stewdk/pwct/wiki/invacare.png

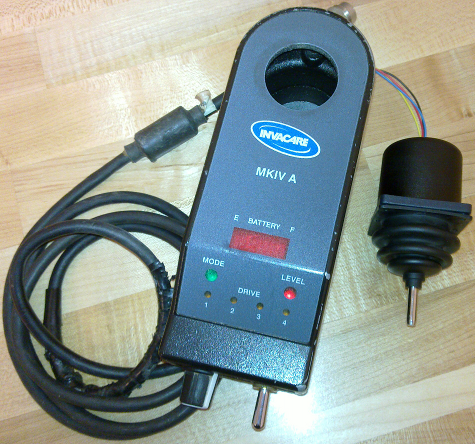
wiki/invacare.png
