stewdk/pwct/wiki/invacare_direction.png

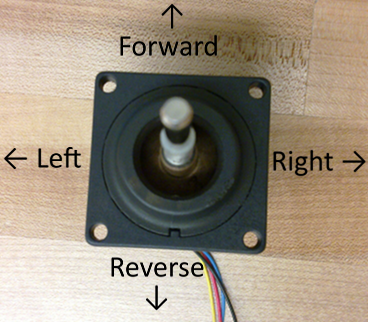
wiki/invacare_direction.png
