stewdk/pwct/hardware/wheelchair/gerber/gerber file info.txt

.GTL top copper
.GBL bottom copper
.GTO top silkscreen
.GBO bottom silkscreen
.GTS top soldermask
.GBS bottom soldermask
.TXT excellon drill file
.GML rs274x mill layer (empty)
