stewdk/pwct/wiki/remoteplus.png

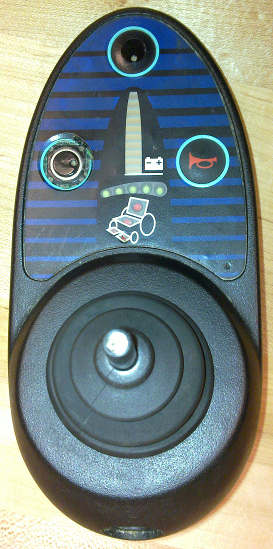
wiki/remoteplus.png
