stewdk/pwct/hardware/Wheelchair Receiver BOM.xlsx

 |  |  |  |  |  |  |  | Total: | $239.43
ID # | Manufacturer | MFG Part # | Description | Supplier | Supplier Part # | Schematic Ref. | Price | Qty | Sub Total | NOTES
Resistors |  |  |  |  |  |  |  |  | $0.00
1 | Stackpole Electronics | RMCF0805JT10K0 | 10kΩ 0805 | Digi-Key | RMCF0805JT10K0CT-ND | R4, R7, R8, R10, R11, R12, R13, R14, R15, R17, R18, R19, R20, R22, R23, R24, R27, R28, R31, R32, R33, R34, R36, R37, R41, R42, R48, R49, R51, R52, R53, R54, R55, R57, R65, R66, R67, R68, R72, R75, R77, R78, R79, R80, R81, R82, R83, R84 | $0.03 | 48 | $1.44
2 | Stackpole Electronics | RMCF0402FT1M00 | 1M 0402 | Digi-Key | RMCF0402FT1M00CT-ND | R1 | $0.04 | 1 | $0.04
3 | Panasonic | ERJ-2RKF2202X | 22k 0402 | Digi-Key | P22.0KLCT-ND | R2 | $0.10 | 1 | $0.10
4 | Panasonic | ERJ-6ENF40R2V | 40 0805 | Digi-Key | P40.2CCT-ND | R3, R69, R70 | $0.10 | 3 | $0.30
5 | Stackpole Electronics | RMCF0805FT147R | 145 0805 | Digi-Key | RMCF0805FT147RCT-ND | R16 | $0.04 | 1 | $0.04
6 | Stackpole Electronics | RMCF0805FT100K | 100k 0805 | Digi-Key | RMCF0805FT100KCT-ND | R21, R43, R44, R45, R46, R47, R64 | $0.04 | 7 | $0.28 | have some
7 | Panasonic | ERJ-6ENF1100V | 110 0805 | Digi-Key | P110CCT-ND | R35 | $0.10 | 1 | $0.10
8 | Stackpole Electronics | RMCF0805FT12K4 | 12.5k 0805 | Digi-Key | RMCF0805FT12K4CT-ND | R38 | $0.04 | 1 | $0.04
9 | Stackpole Electronics | RMCF0805FT1K00 | 1k 0805 | Digi-Key | RMCF0805FT1K00CT-ND | R39, R71, R73 | $0.04 | 3 | $0.12 | already have
10 | Panasonic | ERJ-6ENF4020V | 400 0805 | Digi-Key | P402CCT-ND | R40 | $0.10 | 1 | $0.10
11 | Stackpole Electronics | RMCF0805JT15R0 | 15 0805 | Digi-Key | RMCF0805JT15R0CT-ND | R5, R6, R25, R26, R29, R30, R50, R56 | $0.03 | 8 | $0.24
12 | Stackpole Electronics | RMCF0805FT220R | 220 0805 | Digi-Key | RMCF0805FT220RCT-ND | R58, R59, R60, R61, R62, R63 | $0.04 | 6 | $0.24
13 | Stackpole Electronics | RMCF0805ZT0R00 | 0 0805 | Digi-Key | RMCF0805ZT0R00CT-ND | R9, R74 | $0.03 | 2 | $0.06 | already have
14 | Bourns Inc | 3362P-1-203LF | 20k Potentiometer | Digi-Key | 3362P-203LF-ND | R76 | $1.05 | 1 | $1.05
 |  |  |  |  |  |  |  |  | $0.00
Capacitors |  |  |  |  |  |  |  |  | $0.00
1 | Kemet | T491C107K016ZT | 100uF 2312 | Digi-Key | 399-5214-1-ND | C11, C12 | $1.34 | 2 | $2.68 | Voltage regulator input/output cap
2 | Kemet | C0805C103K5RACTU | 0.01uF 0805 | Digi-Key | 399-1158-1-ND | C10, C16, C21, C26, C31 | $0.05 | 5 | $0.25 | Voltage Regulator boost cap
3 | Taiyo Yuden | TMK105B7103KV-F | 10nF 0402 | Digi-Key | 587-1223-1-ND | C8 | $0.05 | 1 | $0.05
4 | Taiyo Yuden | UMK105B7102KV-F | 1nF 0402 | Digi-Key | 587-1220-1-ND | C9 | $0.05 | 1 | $0.05
5 | Taiyo Yuden | UMK105B7222KV-F | 2.2nF 0402 | Digi-Key | 587-1221-1-ND | C4 | $0.05 | 1 | $0.05
6 | Taiyo Yuden | UMK105CG220JV-F | 22pF 0402 | Digi-Key | 587-1203-1-ND | C1,C2 | $0.06 | 2 | $0.12
7 | Johanson Technology Inc | 500R07S1R0BV4T | 1pF 0402 | Digi-Key | 712-1266-1-ND | C6 | $0.19 | 1 | $0.19
8 | Johanson Technology Inc | 500R07S4R7BV4T | 4.7pF 0402 | Digi-Key | 712-1166-1-ND | C5 | $0.26 | 1 | $0.26
9 | AVX Corp | 04025U1R5BAT2A | 1.5pF 0402 | Digi-Key | 478-5992-1-ND | C7 | $0.16 | 1 | $0.16
10 | TDK Corporation | C1005X7R1E333K | 33nF 0402 | Digi-Key | 445-4939-1-ND | C3 | $0.04 | 1 | $0.04 | Min qty 10
11 | AVX Corp | 08055C104JAT2A | 0.1uF 0805 | Digi-Key | 478-3352-1-ND | C17, C18, C19, C22, C23, C24, C27, C28, C29, C32, C33, C34, C35, C36, C37, C38, C41, C42, C45, C48, C49, C50 | $0.05 | 22 | $1.10 | already have
12 | AVX Corp | 0805PC102KAT1A | 1nF 0805 | Digi-Key | 478-5541-1-ND | C15, C20, C25, C30, C51, C52 | $0.30 | 6 | $1.80 | already have
13 | Murata Electronics | GRM21BR61E106KA73L | 10uF 0805 | Digi-Key | 490-5523-1-ND | C13, C39, C43, C46 | $0.26 | 4 | $1.04
14 | Taiyo Yuden | UMK212BJ105KG-T | 1uF 0805 | Digi-Key | 587-2229-1-ND | C14, C40, C44, C47 | $0.39 | 4 | $1.56 | already have
 |  |  |  |  |  |  |  |  | $0.00
IC |  |  |  |  |  |  |  |  | $0.00
1 | National Semiconductor | LM2674M-3.3/NOPB | 3.3 voltage regulator | Digi-Key | LM2674M-3.3-ND | IC3 | $3.47 | 1 | $3.47
2 | Nordic Semiconductor | nRF24L01P-T | Nordic 2.4GHz Wireless IC | Mouser | 949-NRF24L01P-T | U1 | $3.60 | 1 | $3.60
3 | Allegro Microsystems | ACS716KLATR-12CB-T | ±12A Current Sensor | Digi-Key | 620-1443-1-ND | IC4, IC7, IC10, IC13 | $4.35 | 4 | $17.40
4 | Atmel | ATXMEGA64A1-AU | Xmega64A1 | Mouser | 556-ATXMEGA64A1-AU | IC5 | $7.50 | 1 | $7.50
5 | Linear Technologies | LT1160CS#PBF | Half Bridge Driver | Digi-Key | LT1160CS#PBF-ND | IC1, IC2, IC6, IC8 | $5.65 | 4 | $22.60
6 | NXP Semiconductors | 74LVC2T45DC,125 | 2-bit Level Translator | Digi-Key | 568-5479-1-ND | IC9 | $0.62 | 1 | $0.62
7 | Texas Instruments | SN74LVC8T245DGVR | 8-bit Level Translator | Digi-Key | 296-19287-1-ND | IC11, IC12 | $1.26 | 2 | $2.52
8 | Allegro Microsystems | ACS758LCB-100B-PFF-T | ±100A current sensor | Digi-Key | 620-1321-ND |  | $7.00 | 0 | $0.00 | Rev B
 |  |  |  |  |  |  |  |  | $0.00
Other |  |  |  |  |  |  |  |  | $0.00
1 | Diodes Inc | DMN3404L-7 | logic level Nfet | Digi-Key | DMN3404LDICT-ND | q4, q5, q6, q7, q8, q9 | $0.49 | 0 | $0.00 | Used only for Omni+ output
2 | Fairchild Semiconductor | FDD6630A | half bridge Nfet | Digi-Key | FDD6630ACT-ND | Q2, Q3, Q10, Q11, Q12, Q13, Q16, Q17 | $0.69 | 8 | $5.52
3 | Pulse Electronics Corp | PE-53811SNL | 118uH inductor for voltage regulator | Digi-Key | 553-1395-ND | L4 | $1.89 | 1 | $1.89
4 | Micro Commercial Co | SS24-TP | Schottky Diode | Digi-Key | SS24-TPMSCT-ND | D1, D3, D4, D5, D6 | $0.51 | 5 | $2.55
5 | Lite-On Inc | LTST-C170TBKT | Debug LED 0805 | Digi-Key | 160-1579-1-ND | LED1 | $0.46 | 1 | $0.46
6 | NXP Semiconductors | TL431MSDT,215 | Shunt Voltage Reference | Digi-Key | 568-4880-1-ND | D2 | $0.47 | 1 | $0.47
7 | E-Switch | TL1015AF160QG | Reset Switch | Digi-Key | EG4344CT-ND | SW1 | $0.95 | 1 | $0.95
8 | Johanson Technology Inc | L-07C2N7SV6T | 2.7nH 0402 | Digi-Key | 712-1415-1-ND | L2 | $0.10 | 1 | $0.10
9 | Johanson Technology Inc | L-07C3N9SV6T | 3.9nH 0402 | Digi-Key | 712-1459-1-ND | L1 | $0.10 | 1 | $0.10
10 | Johanson Technology Inc | L-07C8N2JV6T | 8.2nH 0402 | Digi-Key | 712-1420-1-ND | L3 | $0.10 | 1 | $0.10
11 | Abracon Corp | ABM3B-16.000MHZ-10-1-U-T | 16MHz Crystal | Digi-Key | 300-8206-1-ND | Q1 | $1.50 | 1 | $1.50
12 | Micro Commercial Co | AZ23C24-TP | 24V zener, pair, comon anode | Digi-Key | AZ23C24-TPMSCT-ND | d7, d8, d9, d44 | $0.49 | 0 | $0.00 | Used only for Omni+ output
13 | Micro Commercial Co | SK106-TP | Flyback Schottky Diode | Digi-Key | SK106-TPCT-ND | D20, D21, D22, D23, D24, D25, D26, D27 | $1.00 | 8 | $8.00
14 | Micro Commercial Co | BZV55C3V3-TP | 3.3V Zener | Digi-Key | BZV55C3V3-TPMSCT-ND | D17, D18, D19, D48, D49 | $0.38 | 5 | $1.90
15 | Semtech | UCLAMP3304A.TCT | 3.3V TVS | Digi-Key | UCLAMP3304ACT-ND | D10, D11, D12, D13, D45, D46, D50, D51, D52 | $0.57 | 9 | $5.13
16 | Semtech | UCLAMP0504A.TCT | 5V TVS | Digi-Key | UCLAMP0504ACT-ND | D14, D15, D16, D47 | $0.49 | 4 | $1.96
17 | Bourns Inc | SMBJ16CA | 16V Bidirectional TVS | Digi-Key | SMBJ16CABCT-ND | D28, D29, D30, D31, D32, D33, D34, D35 | $0.30 | 8 | $2.40
18 | Bourns Inc | SMAJ26A | 26V Unidirectional TVS | Digi-Key | SMAJ26ABCT-ND | D36, D37, D38, D39, D40, D41, D42, D43 | $0.34 | 8 | $2.72
19 | TE Connectivity | BD280-1927-25/16 | 25A Fuse | Digi-Key | BD280-1927-25-ND |  | $4.41 | 2 | $8.82
20 | Littelfuse, Inc | 178.6152.0001 | Fuse Holder (crimp) | Digi-Key | F5194-ND |  | $3.08 | 2 | $6.16
21 | Newhaven Display Intl | NHD-0216K1Z-NSW-BBW-L | LCD | Digi-Key | NHD-0216K1Z-NSW-BBW-L-ND |  | $11.70 | 1 | $11.70 | May change in future rev
22 | Sharp Microelectronics | GP1A51HRJ00F | Photointerrupter | Digi-Key | 425-1949-5-ND |  | $1.44 | 2 | $2.88
 |  |  |  |  |  |  |  |  | $0.00
Connectors & Switches |  |  |  |  |  |  |  |  | $0.00
1 | Amphenol Commercial | G17S0900110EU | D-sub 9 receptacle Panel Mount (female) | Mouser | 523-G17S0900110EU |  | $0.67 | 0 | $0.00 | Omni
2 | Kobiconn | 161-1640-EX | 1/8" Mono Female | Mouser | 161-1640-EX |  | $1.04 | 6 | $6.24 | 5 buddy buttons, 1 e-stop
3 | CW Industries | GRS-4013C-0001 | Mom-Off-Mom Rocker, Linear Actuators | Digi-Key | SW340-ND |  | $1.62 | 1 | $1.62
4 | TE Connectivity | PRASC1-16F-BBR00 | Bumper Override Rocker Switch | Digi-Key | 450-1041-ND |  | $2.05 | 2 | $4.10
5 | E-Switch | R5BBLKGRNFF2 | DPST Power Switch | Digi-Key | EG1536-ND |  | $2.75 | 1 | $2.75
6 | E-Switch | PS1057ABLK | Pushbuttons for UI | Digi-Key | EG2041-ND |  | $1.63 | 6 | $9.78
7 | Apem | A01ESSP3 | E-stop button | Mouser | 642-A01ES-SP3 |  | $19.38 | 2 | $38.76
8 | Apem | A0150B | E-stop switch block | Mouser | 642-A0150B |  | $6.77 | 2 | $13.54 | Alternative: A0154B
9 | Apem | A01YL1 | E-stop sticker (optional) | Mouser | 642-A01YL1 |  | $2.21 | 2 | $4.42 | Optional
10 | Lumex Opto | SSI-LXH8080GD | Actuator Indicator LED | Digi-Key | 67-1168-ND |  | $1.17 | 1 | $1.17
11 | Amphenol Commercial | G17S0910110EU | D-sub 9 plug panel mount | Mouser | 523-G17S0910110EU |  | $0.58 | 2 | $1.16
12 | Assmann Electronics | AK131-2-R | Board - Omni+ Joystick cable | Digi-Key | AE1379-ND |  | $3.71 | 0 | $0.00 | Omni
13 | Kobiconn | 172-2136 | E-Stop Mono Cable | Mouser | 172-2136 |  | $2.35 | 1 | $2.35 | Bare end hooks up to e-stop buttons
14 | Kobiconn | 172-2137 | Omni+ On/Off Cable | Mouser | 172-2137 |  | $3.15 | 0 | $0.00 | Omni
15 | FCI | 68602-406HLF | Programming header | Mouser | 649-68602-406HLF | PROG1 | $0.12 | 1 | $0.12
16 | Molex | 22-28-4360 | Straight Male header | Digi-Key | WM6436-ND |  | $1.18 | 4 | $4.72
17 | TE Connectivity | 881545-2 | Shunt Jumpers | Digi-Key | A26242-ND |  | $0.21 | 10 | $2.13 | Min qty 10
18 | Phoenix Contact | 1935187 | Motor driver connector | Digi-Key | 277-1579-ND | JP15 | $0.64 | 1 | $0.64
19 | Keystone Electronics | 7200 | Hex standoff 3/8" | Digi-Key | 7200K-ND |  | $0.68 | 4 | $2.72
20 | Sullins Connector Solutions | PPTC161LFBN-RC | Female pin header 16 pos single row | Digi-Key | S7014-ND |  | $1.22 | 1 | $1.22
21 | Sullins Connector Solutions | PPTC061LFBN-RC | Female pin header 6 pos single row | Digi-Key | S7004-ND |  | $0.67 | 1 | $0.67
22 | Sullins Connector Solutions | PPTC031LFBN-RC | Female pin header 3 pos single row | Digi-Key | S7001-ND |  | $0.63 | 2 | $1.26
23 | Sullins Connector Solutions | PPTC021LFBN-RC | Female pin header 2 pos single row | Digi-Key | S7000-ND |  | $0.49 | 2 | $0.98
24 | Sullins Connector Solutions | PPTC122LFBN-RC | Female pin header 24 pos double row | Digi-Key | S7080-ND |  | $1.73 | 1 | $1.73
25 | Sullins Connector Solutions | PPTC042LFBN-RC | Female pin header 8 pos double row | Digi-Key | S7072-ND |  | $0.83 | 1 | $0.83
