stewdk/pwct/hardware/Connector BOM.xlsx

Sheet: Connector
Category | Description | Manufacturer | Mfg part number | Supplier | Supplier part number | Price × 1 | Quantity | Price × Qty
Battery cable (6 AWG) | Ring terminals (7 or 8 mm) | Molex | 19071-0196 | Mouser | 538-19071-0196 | $0.66 | 4 | $2.64
 | Disconnect housing | Anderson Power Products | 6810G1-BK | Mouser | 879-6810G1-BK | $4.71 | 4 | $18.84
 | Disconnect contact 6 AWG | Anderson Power Products | 1319G6-BK | Mouser | 879-1319G6-BK | $3.26 | 8 | $26.08
 | Panel mount housing | Anderson Power Products | 1321-BK | Mouser | 879-1321-BK | $4.95 | 6 | $29.70
 | Panel mount contact 6 AWG | Anderson Power Products | 1319G6-BK | Mouser | 879-1319G6-BK | $3.26 | 6 | $19.56
 | Panel mount plates (pair - complain to Mouser if single) | Anderson Power Products | 1464G2 | Mouser | 879-1464G2 | $7.04 | 1 | $7.04
 | Additional contact 4 AWG | Anderson Power Products | 1319G4-BK | Mouser | 879-1319G4-BK | $3.14 | 1 | $3.14
 | Additional contact 2 AWG | Anderson Power Products | 1319-BK | Mouser | 879-1319-BK | $3.14 | 0 | $0.00
Motor (8 AWG) | PP75 red housing | Anderson Power Products | 5916G7-BK | Mouser | 879-5916G7-BK | $1.47 | 4 | $5.88
 | PP75 black housing | Anderson Power Products | 5916G4-BK | Mouser | 879-5916G4-BK | $1.47 | 4 | $5.88
 | contact | Anderson Power Products | 5900-BK | Mouser | 879-5900-BK | $0.62 | 8 | $4.96
 | Panel mount (pair) | Anderson Power Products | 1463G1 | Mouser | 879-1463G1 | $4.19 | 2 | $8.38
Photointerrupter | Panel mount | Neutrik | RT3MP | Mouser | 568-RT3MP-B | $1.86 | 2 | $3.72
 | Plug | Neutrik | RT3FC-B | Mouser | 568-RT3FC-B | $2.54 | 2 | $5.08
Connector to front | Panel mount (housing only) | Molex | 15-06-0245 | Mouser | 538-15-06-0245 | $2.07 | 1 | $2.07
 | Plug | Molex | 39-01-2240 | Mouser | 538-39-01-2240 | $1.25 | 1 | $1.25
 | Female Socket crimp contacts 16 AWG | Molex | 45750-3111 | Mouser | 538-45750-3111 | $0.09 | 24 | $2.04
 | Male Pin crimp contacts 16 AWG | Molex | 46012-3142 | Mouser | 538-46012-3142 | $0.22 | 24 | $5.33
Charging connector | XLR receptacle (panel mount) | Neutrik | NC3FD-LX-0 | Mouser | 568-NC3FD-LX-0 | $3.32 | 1 | $3.32
 | XLR receptacle (cable) | Switchcraft | AAA3FPZ | Mouser | 502-AAA3FPZ | $3.19 | 1 | $3.19
Fuses | 8A or 10A charging |  |  |  |  |  |  | $0.00
Wire | 6 AWG Red (foot) |  |  | McMaster-Carr | 6948K912 | $1.68 | 9 | $15.12
 | 6 AWG Black (foot) |  |  | McMaster-Carr | 6948K911 | $1.68 | 9 | $15.12
 | 8 AWG Red (foot) |  |  | McMaster-Carr | 6948K892 | $1.18 | 3 | $3.54
 | 8 AWG Black (foot) |  |  | McMaster-Carr | 6948K891 | $1.18 | 3 | $3.54
 | 24AWG Black (foot) |  |  | McMaster-Carr | 7587K921 | $0.09 | 150 | $13.79
 | 24AWG White (foot) |  |  | McMaster-Carr | 7587K924 | $0.09 | 150 | $13.79
 | 16AWG Black (foot) |  |  | McMaster-Carr | 7587K961 | $0.23 | 50 | $11.44
 | 16AWG Red (foot) |  |  | McMaster-Carr | 7587K962 | $0.23 | 50 | $11.44
 | 16AWG Yellow (foot) |  |  | McMaster-Carr | 7587K963 | $0.23 | 50 | $11.43
 | 3-conductor wire (foot) |  |  | McMaster-Carr | 9936K25 | $1.47 | 20 | $29.40
Wire sleeves | Mesh sleeving |  |  | McMaster-Carr | 9284K415 | $7.95 | 1 | $7.95
 | D-sub standoffs |  |  | McMaster-Carr | 93620A701 | $1.40 | 4 | $5.60
 |  |  |  |  |  |  |  | $294.64

Sheet: McMaster only
Category | Description | Supplier | Supplier part # | Price × 1 | Quantity | Price × Qty
Wire | Red 6 AWG (foot) | McMaster-Carr | 6948K912 | $1.68 | 9 | $15.12
 | Black 6 AWG (foot) | McMaster-Carr | 6948K911 | $1.68 | 9 | $15.12
 | Red 8 AWG (foot) | McMaster-Carr | 6948K892 | $1.18 | 3 | $3.54
 | Black 8 AWG (foot) | McMaster-Carr | 6948K891 | $1.18 | 3 | $3.54
Wire sleeves | Mesh sleeving | McMaster-Carr | 9284K415 | $7.95 | 1 | $7.95
