stewdk/pwct/hardware/Remote BOM.xlsx

 |  |  |  |  |  |  |  | Total: | $36.50
ID # | Manufacturer | MFG Part # | Description | Supplier | Supplier Part # | Schematic Ref. | Price | Qty | Sub Total | NOTES
Resistors |  |  |  |  |  |  |  |  | $0.00
1 | Stackpole Electronics | RMCF0402FT1M00 | 1M 0402 | Digi-Key | RMCF0402FT1M00CT-ND | R1 | $0.04 | 1 | $0.04
2 | Susumu | RR0510P-223-D | 22k ±1% 0402 | Digi-Key | RR05P22.0KDCT-ND | R2 | $0.08 | 1 | $0.08
3 | Stackpole Electronics | RMCF0402JT100K | 100k 0402 | Digi-Key | RMCF0402JT100KCT-ND | R3, R7, R8, R9, R10 | $0.02 | 5 | $0.10
4 | Stackpole Electronics | RMCF0402JT110R | 110 0402 | Digi-Key | RMCF0402JT110RCT-ND | R4 | $0.02 | 1 | $0.02
5 | Stackpole Electronics | RMCF0402FT75K0 | 75k 0402 | Digi-Key | RMCF0402FT75K0CT-ND | R6 | $0.04 | 1 | $0.04
6 | Stackpole Electronics | RMCF0402FT330K | 330k 0402 | Digi-Key | RMCF0402FT330KCT-ND | R5 | $0.04 | 1 | $0.04
 |  |  |  |  |  |  |  |  | $0.00
Capacitors |  |  |  |  |  |  |  |  | $0.00
7 | Taiyo Yuden | TMK105BJ104KV-F | 0.1μF 0402 | Digi-Key | 587-1456-1-ND | C10 | $0.10 | 1 | $0.10
8 | Taiyo Yuden | TMK105B7103KV-F | 10nF 0402 | Digi-Key | 587-1223-1-ND | C8 | $0.10 | 1 | $0.10
9 | Taiyo Yuden | UMK105B7102KV-F | 1nF 0402 | Digi-Key | 587-1220-1-ND | C9 | $0.10 | 1 | $0.10
10 | Taiyo Yuden | UMK105B7222KV-F | 2.2nF 0402 | Digi-Key | 587-1221-1-ND | C4 | $0.10 | 1 | $0.10
11 | Taiyo Yuden | UMK105CG220JV-F | 22pF 0402 | Digi-Key | 587-1203-1-ND | C1,C2 | $0.10 | 2 | $0.20 | $0.017 @ 10
12 | TDK Corporation | C1005C0G1H010B | 1pF 0402 | Digi-Key | 445-4854-1-ND | C6 | $0.10 | 1 | $0.10
13 | TDK Corporation | C1005C0G1H4R7B | 4.7pF 0402 | Digi-Key | 445-4878-1-ND | C5 | $0.10 | 1 | $0.10
14 | TDK Corporation | C1005C0G1H1R5B | 1.5pF 0402 | Digi-Key | 445-4858-1-ND | C7 | $0.10 | 1 | $0.10
15 | TDK Corporation | C1005X7R1E333K | 33nF 0402 | Digi-Key | 445-4939-1-ND | C3 | $0.10 | 1 | $0.10
16 | TDK Corporation | C1608X5R0J226M | 22μF 0603 | Digi-Key | 445-8028-1-ND | C11, C14, C15 | $0.38 | 3 | $1.14
17 | Kemet | C0402C105K9PACTU | 1μF 0402 | Digi-Key | 399-4873-1-ND | C12, C13 | $0.07 | 2 | $0.14
 |  |  |  |  |  |  |  |  | $0.00
Inductors |  |  |  |  |  |  |  |  | $0.00
18 | Johanson Technology Inc. | L-07C2N7SV6T | 2.7nH 0402 | Digi-Key | 712-1415-1-ND | L2 | $0.10 | 1 | $0.10
19 | Johanson Technology Inc. | L-07C3N9SV6T | 3.9nH 0402 | Digi-Key | 712-1459-1-ND | L1 | $0.10 | 1 | $0.10
20 | Johanson Technology Inc. | L-07C8N2JV6T | 8.2nH 0402 | Digi-Key | 712-1420-1-ND | L3 | $0.10 | 1 | $0.10
21 | TDK Corporation | CPL2512T2R2M | 2.2μH 0805 | Digi-Key | 445-4172-1-ND | L4, L5 | $0.45 | 2 | $0.90
 |  |  |  |  |  |  |  |  | $0.00
IC's |  |  |  |  |  |  |  |  | $0.00
22 | Atmel | ATTINY461V-10MUR | Attiny461 microcontroller QFN32 | Digi-Key | ATTINY461V-10MURCT-ND | IC1 | $3.05 | 1 | $3.05
23 | Nordic Semiconductor | nRF24L01P-T | Nordic Wireless | Mouser | 949-NRF24L01P-T | IC2 | $3.60 | 1 | $3.60
24 | Texas Instruments | TPS61200DRCT | Adjustable Boost regulator | Digi-Key | 296-21663-1-ND | IC3 | $3.74 | 1 | $3.74
25 | Texas Instruments | TPS61202DSCR | 5V Boost regulator | Digi-Key | 296-24865-1-ND | IC4 | $3.17 | 1 | $3.17
 |  |  |  |  |  |  |  |  | $0.00
Other |  |  |  |  |  |  |  |  | $0.00
26 | Abracon Corp | ABM3B-16.000MHZ-10-1-U-T | 16MHz Crystal | Digi-Key | 300-8206-1-ND | XTAL1 | $1.50 | 1 | $1.50
27 | Semtech | UCLAMP3304A.TCT | 3.3V TVS | Digi-Key | UCLAMP3304ACT-ND | D1 | $0.57 | 1 | $0.57
28 | CHIPLED | LS Q976-NR-1-0-20-R18 | LED RED 0603 | Digi-Key | 475-2512-1-ND | LED1 | $0.13 | 1 | $0.13
29 | Fairchild Semiconductor | MBR0520L | Reverse battery protection diode | Digi-Key | MBR0520LCT-ND | D2 | $0.36 | 1 | $0.36 | throughhole: 1N5817-TPCT-ND
30 | FCI | 67996-206HLF | Header AVR programming | Digi-Key | 609-3210-ND | AVR | $0.29 | 1 | $0.29
31 | Sparkfun |  | Thumb Joystick PS2 style | Sparkfun | COM-09032 | JSTICK1 | $3.95 | 1 | $3.95
32 | Kobiconn | 161-1640-EX | 3.5mm mono jack female | Mouser | 161-1640-EX |  | $1.04 | 4 | $4.16
33 | Molex | 22-28-4360 | Male pin header | Digi-Key | WM6436-ND |  | $1.18 | 1 | $1.18
34 | Sullins Connector Solutions | PPTC042LFBN-RC | 2x4 Female pin header | Digi-Key | S7072-ND |  | $0.83 | 1 | $0.83
35 | Sullins Connector Solutions | PPTC021LFBN-RC | 2x1 Female pin header | Digi-Key | S7000-ND |  | $0.49 | 1 | $0.49
36 |  |  | 1x1 Female pin header | Digi-Key |  |  |  |  | $0.00
37 | MPD (Memory Protection Devices) | BC2AAW | Battery Holder 2xAA | Digi-Key | BC2AAW-ND | BAT1 | $0.85 | 1 | $0.85
38 | Cherry | PRK22J5DBBNN | On/off switch | Digi-Key | CH865-ND |  | $1.36 | 2 | $2.72
39 | CW Industries | GPB507A05BR | Red e-stop Button | Digi-Key | SW637-ND |  | $2.11 | 1 | $2.11
 |  |  |  |  |  |  |  |  | $0.00
