stewdk/pwct/wheelchair/src/PWCT_io.c

/*
 * PWCT_io.c
 *
 *  Created on: Mar 28, 2011
 *      Author: grant
 */

#include <avr/io.h>
#include <util/delay.h>
#include <stdio.h>
#include "../atmel/TC_driver.h"
#include "../atmel/port_driver.h"
#include "../atmel/pmic_driver.h"
#include "../atmel/adc_driver.h"
#include "nordic_driver.h"
#include "util.h"
#include "PWCT_io.h"

//pulse timer 1tick = 8us
//31250 ticks = 250ms
#define PGDT_ESTOP_PULSE_PERIOD 31250

#define ENABLE_INSTRUCTOR_REMOTE_LINEAR_ACTUATOR_CONTROL	0

/* Input/Output List
 *  Item							Pin			In/Out		Note
 *  Prop. Joy Detect				PK7			Input
 *  Prop. Joy Speed (Fwd/Rev)		PA1			Input		A/D
 *  Prop. Joy Direction (L/R)		PA2			Input		A/D
 *	Bumper							PA7			Input		optional A/D
 *	Limit Switch 1					PA3			Input		A/D
 *	Limit Switch 2					PA4			Input		A/D
 *	Limit Switch 3					PA5			Input		A/D
 *	Limit Switch 4					PA6			Input		A/D
 *	Student Forward					PJ3			Input
 *	Student Reverse					PJ4			Input
 *	Student Left					PJ5			Input
 *	Student Right					PJ6			Input
 *	Student Fifth					PJ7			Input
 *	Buddy Button Forward			PH6			Input
 *	Buddy Button Reverse			PH7			Input
 *	Buddy Button Left				PJ0			Input
 *	Buddy Button Right				PJ1			Input
 *	Buddy Button Fifth				PJ2			Input
 *	Emergency Stop					PK2			Input		Normally closed, debounce
 *	Omni+ On/Off Switch				PK6			Output
 *	Panel LA Up						PK0			Input
 *	Panel LA Down					PK3			Input
 *	Panel LA LED					PK5			Output
 *	Panel Bumper Override LED		PK4			Output
 *	Panel Bumper Override Switch	PK1			Input
 *	Omni+ Out Forward				PH1			Output
 *	Omni+ Out Reverse				PH0			Output
 *	Omni+ Out Left					PH4			Output
 *	Omni+ Out Right					PH3			Output
 *	Omni+ Out Fifth					PH5			Output
 *	LCD Button 1					PQ0			Input		Debounce
 *	LCD Button 2					PQ1			Input		Debounce
 *	LCD Button 3					PQ2			Input		Debounce
 *	LCD Button 4					PQ3			Input		Debounce
 *	Extra I/O pin					PR0			I/O
 *	Fwd/Rev Invert					PR1			Input
 */

//these input flags are all active low
static uint8_t BB_FORWARD;
static uint8_t BB_REVERSE;
static uint8_t BB_LEFT;
static uint8_t BB_RIGHT;
static uint8_t BB_FIFTH;
static uint8_t STUDENT_FORWARD;
static uint8_t STUDENT_REVERSE;
static uint8_t STUDENT_LEFT;
static uint8_t STUDENT_RIGHT;
static uint8_t STUDENT_FIFTH;
static uint8_t PANEL_LA_UP;
static uint8_t PANEL_LA_DOWN;
static uint8_t PANEL_BUMPER_OVERRIDE;
static uint8_t PROP_JOY_DETECT;
static uint8_t INVERT_SWITCH;
static uint8_t LIMIT_SWITCH;

#define DEBOUNCED_INPUT_COUNT 5
static debounced_input gDebouncedInputs[DEBOUNCED_INPUT_COUNT];

static volatile uint16_t gWiredPropJoySpeed;
static volatile uint16_t gWiredPropJoyDirection;

static void joystickADCsetup(void)
{
	// ADC configuration for proportional joystick
	ADC_CalibrationValues_Load(&ADCA);

	ADC_ConvMode_and_Resolution_Config(&ADCA, ADC_ConvMode_Unsigned, ADC_RESOLUTION_12BIT_gc);

	// External reference on PA0/AREFA
	ADC_Reference_Config(&ADCA, ADC_REFSEL_AREFA_gc);
	ADC_Prescaler_Config(&ADCA, ADC_PRESCALER_DIV512_gc);

	// In Unsigned Single-ended mode, the conversion range is from ground to the reference voltage.
	ADC_Ch_InputMode_and_Gain_Config(&ADCA.CH0, ADC_CH_INPUTMODE_SINGLEENDED_gc, ADC_DRIVER_CH_GAIN_NONE);
	ADC_Ch_InputMode_and_Gain_Config(&ADCA.CH1, ADC_CH_INPUTMODE_SINGLEENDED_gc, ADC_DRIVER_CH_GAIN_NONE);

	ADC_Ch_InputMux_Config(&ADCA.CH0, ADC_CH_MUXPOS_PIN1_gc, 0);
	ADC_Ch_InputMux_Config(&ADCA.CH1, ADC_CH_MUXPOS_PIN2_gc, 0);

	ADC_FreeRunning_Enable(&ADCA);
	ADC_SweepChannels_Config(&ADCA, ADC_SWEEP_01_gc);

	//ADC_Events_Config(&ADCA, ADC_EVSEL_0123_gc, ADC_EVACT_SYNCHSWEEP_gc );
	ADC_Ch_Interrupts_Config(&ADCA.CH0, ADC_CH_INTMODE_COMPLETE_gc, ADC_CH_INTLVL_MED_gc);
	ADC_Ch_Interrupts_Config(&ADCA.CH1, ADC_CH_INTMODE_COMPLETE_gc, ADC_CH_INTLVL_MED_gc);

	PMIC.CTRL |= PMIC_MEDLVLEN_bm;

	ADC_Enable(&ADCA);
	ADC_Wait_32MHz(&ADCA);
}

static void setupEstopTimer()
{
	// TCF1 is the timer used for Omni E-stop pulse
	//turn off timers
	TC1_ConfigClockSource( &TCF1, TC_CLKSEL_OFF_gc );

	// Set the TC period.
	TC_SetPeriod( &TCF1, 0xFFFF );

	//Set timer in normal mode
	TC1_ConfigWGM( &TCF1, TC_WGMODE_NORMAL_gc );

	TC1_SetCCBIntLevel(&TCF1, TC_CCBINTLVL_MED_gc);

	//start clocks
	TC1_ConfigClockSource( &TCF1, TC_CLKSEL_DIV256_gc );

	PMIC.CTRL |= PMIC_MEDLVLEN_bm;
}

static void setupDebouncedInputs()
{
	//LCD Button 1 PQ0
#define DEBOUNCE_INDEX_LCD1 0
	gDebouncedInputs[DEBOUNCE_INDEX_LCD1].port = &PORTQ;
	gDebouncedInputs[DEBOUNCE_INDEX_LCD1].pin_bm = PIN0_bm;

	//LCD Button 2 PQ1
#define DEBOUNCE_INDEX_LCD2 1
	gDebouncedInputs[DEBOUNCE_INDEX_LCD2].port = &PORTQ;
	gDebouncedInputs[DEBOUNCE_INDEX_LCD2].pin_bm = PIN1_bm;

	//LCD Button 3 PQ2
#define DEBOUNCE_INDEX_LCD3 2
	gDebouncedInputs[DEBOUNCE_INDEX_LCD3].port = &PORTQ;
	gDebouncedInputs[DEBOUNCE_INDEX_LCD3].pin_bm = PIN2_bm;

	//LCD Button 4 PQ3
#define DEBOUNCE_INDEX_LCD4 3
	gDebouncedInputs[DEBOUNCE_INDEX_LCD4].port = &PORTQ;
	gDebouncedInputs[DEBOUNCE_INDEX_LCD4].pin_bm = PIN3_bm;

	//Panel E-stop
#define DEBOUNCE_INDEX_ESTOP 4
	gDebouncedInputs[DEBOUNCE_INDEX_ESTOP].port = &PORTK;
	gDebouncedInputs[DEBOUNCE_INDEX_ESTOP].pin_bm = PIN2_bm;

	int i;
	for (i = 0; i < DEBOUNCED_INPUT_COUNT; i++)
	{
		// Set as input
		gDebouncedInputs[i].port->DIRCLR = gDebouncedInputs[i].pin_bm;

		// Enable pull-up
		PORTCFG.MPCMASK = gDebouncedInputs[i].pin_bm;
		gDebouncedInputs[i].port->PIN0CTRL = PORT_OPC_PULLUP_gc;

		// Default values
		gDebouncedInputs[i].previous_values = UINT8_MAX;
		gDebouncedInputs[i].debounced_value = 1;
		gDebouncedInputs[i].previous_debounced_value = 1;
		gDebouncedInputs[i].pressedCount = 0;
	}

	// E-stop needs an initial value of 0 since it is a normally closed switch
	gDebouncedInputs[DEBOUNCE_INDEX_ESTOP].previous_values = 0;
	gDebouncedInputs[DEBOUNCE_INDEX_ESTOP].debounced_value = 0;
	gDebouncedInputs[DEBOUNCE_INDEX_ESTOP].previous_debounced_value = 0;
}

static void setupDebounceTimer()
{
	// TCC1 is the timer used for debouncing
	TCC1.CTRLA = TC_CLKSEL_DIV4_gc;
	TCC1.CTRLB = TC_WGMODE_FRQ_gc;
	TCC1.INTCTRLB = TC_CCAINTLVL_LO_gc;
	TCC1.CCA = 40000; // Goal: interrupt every 5 milliseconds

	PMIC.CTRL |= PMIC_LOLVLEN_bm;
}

void initPWCTio(void)
{
	setupEstopTimer();

	setupDebouncedInputs();

	setupDebounceTimer();

	PORT_ConfigurePins( &PORTH, PIN6_bm | PIN7_bm,                     false, false, PORT_OPC_PULLUP_gc, PORT_ISC_BOTHEDGES_gc ); // BB fwd, BB rev
	PORT_ConfigurePins( &PORTJ, 0xFF,                                  false, false, PORT_OPC_PULLUP_gc, PORT_ISC_BOTHEDGES_gc ); // remaining BB, switch joystick in
	PORT_ConfigurePins( &PORTK, PIN0_bm | PIN1_bm | PIN3_bm | PIN7_bm, false, false, PORT_OPC_PULLUP_gc, PORT_ISC_BOTHEDGES_gc ); // LA up, bumper override, LA down, Prop. Joy Detect
	PORT_ConfigurePins( &PORTK, PIN2_bm,                               false, false, PORT_OPC_PULLUP_gc, PORT_ISC_BOTHEDGES_gc ); // e-stop button
	PORT_ConfigurePins( &PORTQ, PIN0_bm | PIN1_bm | PIN2_bm | PIN3_bm, false, false, PORT_OPC_PULLUP_gc, PORT_ISC_BOTHEDGES_gc ); // LCD buttons
	PORT_ConfigurePins( &PORTR, PIN0_bm | PIN1_bm,                     false, false, PORT_OPC_PULLUP_gc, PORT_ISC_BOTHEDGES_gc ); // LCD button, invert switch

	PORT_SetPinsAsInput( &PORTH, PIN6_bm | PIN7_bm);
	PORT_SetPinsAsInput( &PORTJ, PIN0_bm | PIN1_bm | PIN2_bm | PIN3_bm | PIN4_bm | PIN5_bm | PIN6_bm | PIN7_bm );
	PORT_SetPinsAsInput( &PORTK,  PIN0_bm | PIN1_bm | PIN2_bm | PIN3_bm | PIN7_bm);
	PORT_SetPinsAsInput( &PORTQ,  PIN0_bm | PIN1_bm | PIN2_bm | PIN3_bm);
	PORT_SetPinsAsInput( &PORTR,  PIN0_bm | PIN1_bm);

	//set outputs
	PORTK.OUTCLR = PIN4_bm | PIN5_bm;	//leds off
	PORTK.OUTCLR = PIN6_bm;				//Omni+ on/off switch disabled
	PORTK.DIRSET = PIN4_bm | PIN5_bm | PIN6_bm;
	PORTH.OUTCLR = PIN0_bm | PIN1_bm | PIN3_bm | PIN4_bm | PIN5_bm;	//switch joystick disabled
	PORTH.DIRSET = PIN0_bm | PIN1_bm | PIN3_bm | PIN4_bm | PIN5_bm;

	joystickADCsetup();

	//get default values
	SampleInputs();

	PMIC.CTRL |= PMIC_MEDLVLEN_bm;
}

void SampleInputs(void)
{
	BB_FORWARD				= PORTH.IN & PIN6_bm;
	BB_REVERSE				= PORTH.IN & PIN7_bm;
	BB_LEFT					= PORTJ.IN & PIN0_bm;
	BB_RIGHT				= PORTJ.IN & PIN1_bm;
	BB_FIFTH				= PORTJ.IN & PIN2_bm;
	STUDENT_FORWARD			= PORTJ.IN & PIN3_bm;
	STUDENT_REVERSE			= PORTJ.IN & PIN4_bm;
	STUDENT_LEFT			= PORTJ.IN & PIN5_bm;
	STUDENT_RIGHT			= PORTJ.IN & PIN6_bm;
	STUDENT_FIFTH			= PORTJ.IN & PIN7_bm;
	PANEL_LA_UP				= PORTK.IN & PIN3_bm;
	PANEL_LA_DOWN			= PORTK.IN & PIN0_bm;
	PANEL_BUMPER_OVERRIDE	= PORTK.IN & PIN1_bm;
	PROP_JOY_DETECT			= PORTK.IN & PIN7_bm;
	INVERT_SWITCH			= PORTR.IN & PIN1_bm;
	LIMIT_SWITCH			= 0;
}

void OmniStopMove(void)
{
	PORTH.OUTCLR = PIN0_bm | PIN1_bm | PIN3_bm | PIN4_bm | PIN5_bm;
}

//moveDir is a bit field of active directions 0b000SFVLR
//S = Select/Fifth button
//F = Forward
//V = Reverse
//L = Left
//R = Right
void OmniMove(uint8_t moveDir)
{
	/*	Out Forward		PH1
	 *	Out Reverse		PH0
	 *	Out Left		PH4
	 *	Out Right		PH3
	 *	Out Fifth		PH5
	 */

	if(moveDir & 0x10) {			//fifth button
		PORTH.OUTSET = PIN5_bm;
	}
	else {
		PORTH.OUTCLR = PIN5_bm;
	}


	if((moveDir & 0x0C) == 0x08) {	//forward
		PORTH.OUTSET = PIN1_bm;
	}
	else {
		PORTH.OUTCLR = PIN1_bm;
	}

	if((moveDir & 0x0C) == 0x04) {	//reverse
		PORTH.OUTSET = PIN0_bm;
	}
	else {
		PORTH.OUTCLR = PIN0_bm;
	}

	if((moveDir & 0x03) == 0x02) {	//left
		PORTH.OUTSET = PIN4_bm;
	}
	else {
		PORTH.OUTCLR = PIN4_bm;
	}

	if((moveDir & 0x03) == 0x01) {	//right
		PORTH.OUTSET = PIN3_bm;
	}
	else {
		PORTH.OUTCLR = PIN3_bm;
	}
}

uint16_t getWiredPropJoySpeed(void)
{
	uint16_t returnValue;
	AVR_ENTER_CRITICAL_REGION();
	returnValue = gWiredPropJoySpeed;
	AVR_LEAVE_CRITICAL_REGION();
	return returnValue;
}

uint16_t getWiredPropJoyDirection(void)
{
	uint16_t returnValue;
	AVR_ENTER_CRITICAL_REGION();
	returnValue = gWiredPropJoyDirection;
	AVR_LEAVE_CRITICAL_REGION();
	return returnValue;
}

static uint8_t isInputFallingEdge(uint8_t i)
{
	uint8_t isFallingEdge = 0;
	AVR_ENTER_CRITICAL_REGION();
	if (gDebouncedInputs[i].debounced_value == 0 && gDebouncedInputs[i].debounced_value != gDebouncedInputs[i].previous_debounced_value)
	{
		isFallingEdge = 1;
	}
	gDebouncedInputs[i].previous_debounced_value = gDebouncedInputs[i].debounced_value;
	AVR_LEAVE_CRITICAL_REGION();
	return isFallingEdge;
}

static uint8_t isInputLongPress(uint8_t i)
{
	uint8_t isLongPress = 0;
	AVR_ENTER_CRITICAL_REGION();
	if (gDebouncedInputs[i].pressedCount > 400 && gDebouncedInputs[i].pressedCount < UINT16_MAX) {
		gDebouncedInputs[i].pressedCount = UINT16_MAX;
		isLongPress = 1;
	}
	AVR_LEAVE_CRITICAL_REGION();
	return isLongPress;
}

uint8_t lcdUpFallingEdge(void)
{
	return isInputFallingEdge(DEBOUNCE_INDEX_LCD4);
}

uint8_t lcdDownFallingEdge(void)
{
	return isInputFallingEdge(DEBOUNCE_INDEX_LCD3);
}

uint8_t lcdRightFallingEdge(void)
{
	return isInputFallingEdge(DEBOUNCE_INDEX_LCD1);
}

uint8_t lcdLeftFallingEdge(void)
{
	return isInputFallingEdge(DEBOUNCE_INDEX_LCD2);
}

uint8_t lcdLeftLongPress(void)
{
	return isInputLongPress(DEBOUNCE_INDEX_LCD2);
}

bool LimitSwitchPressed(void)
{
	return !LIMIT_SWITCH;
}

/* 0 = NO
 * 1 = DOWN
 * 2 = UP
 */
uint8_t ActuatorSwitchPressed(void)
{
	//panel controls take priority over instructor remote controls
	if(!PANEL_LA_UP && PANEL_LA_DOWN) {
		return 2;	//up is pressed
	}
	else if(PANEL_LA_UP && !PANEL_LA_DOWN) {
		return 1;	//down is pressed
	}
#if ENABLE_INSTRUCTOR_REMOTE_LINEAR_ACTUATOR_CONTROL
	else if(INSTRUCTOR_LA_UP && !INSTRUCTOR_LA_DOWN) {
		return 2;	//up is pressed
	}
	else if(!INSTRUCTOR_LA_UP && INSTRUCTOR_LA_DOWN) {
		return 1;	//down is pressed
	}
#endif
	else {
		return 0;	//nothing is pressed or up and down are both pressed
	}
}

bool PanelEStopPressed(void)
{
	// normally closed switch
	return gDebouncedInputs[DEBOUNCE_INDEX_ESTOP].debounced_value;
}

void PulsePGDTEstop(void)
{
	PORTK.OUTSET = PIN6_bm;
	//start pulse timer
	TC_SetCompareB(&TCF1, TCF1.CNT + PGDT_ESTOP_PULSE_PERIOD);
	TC1_EnableCCChannels( &TCF1, TC1_CCBEN_bm);
}

ISR(TCF1_CCB_vect)  //Omni e-stop
{
	if((TCF1.CTRLB & TC1_CCBEN_bm) == 0) {
		return;
	}
	TC1_DisableCCChannels( &TCF1, TC1_CCBEN_bm);
	PORTK.OUTCLR = PIN6_bm;
}

ISR(ADCA_CH0_vect)
{
	AVR_ENTER_CRITICAL_REGION();
	gWiredPropJoySpeed = ADC_ResultCh_GetWord(&ADCA.CH0);
	AVR_LEAVE_CRITICAL_REGION();
}

ISR(ADCA_CH1_vect)
{
	AVR_ENTER_CRITICAL_REGION();
	gWiredPropJoyDirection = ADC_ResultCh_GetWord(&ADCA.CH1);
	AVR_LEAVE_CRITICAL_REGION();
}

// Debounce timer ISR
ISR(TCC1_CCA_vect)
{
	int i;
	for (i = 0; i < DEBOUNCED_INPUT_COUNT; i++)
	{
		gDebouncedInputs[i].previous_values = (gDebouncedInputs[i].previous_values << 1) | ((gDebouncedInputs[i].port->IN & gDebouncedInputs[i].pin_bm) ? 1 : 0);

		if (gDebouncedInputs[i].previous_values == UINT8_MAX)
		{
			gDebouncedInputs[i].debounced_value = 1;
			gDebouncedInputs[i].pressedCount = 0;
		}
		else if (gDebouncedInputs[i].previous_values == 0)
		{
			gDebouncedInputs[i].debounced_value = 0;
			if (gDebouncedInputs[i].pressedCount < UINT16_MAX - 1) {
				gDebouncedInputs[i].pressedCount++;
			}
		}
	}
}
