stewdk/pwct/(commit log)

2012-03-05 Added schematics. Beware - needs fixing.
    [Remote.brd, Remote.sch, Wheelchair Receiver BOM.xlsx, Wheelchair.brd, Wheelchair.sch]
2012-03-06 Reorganized some files, added library file
    [Remote.brd, Remote.sch, Wheelchair.brd, Wheelchair.sch]
2012-03-06 Fixed remote schematic
2012-03-06 Fixed remote schematic - try 2
    [Remote.brd, Remote.sch, Wheelchair Receiver BOM.xlsx]
2012-03-06 Minor fixes in wheelchair schematic
    [Wheelchair Receiver BOM.xlsx, Wheelchair.brd, Wheelchair.sch]
2012-03-07 Wheelchair board - removed bumper inputs, added LCD interface - still lots to do
    [Wheelchair.brd, Wheelchair.sch]
2012-03-08 Started to add motor controller interface, routing checkpoint
    [Wheelchair.brd, Wheelchair.sch]
2012-03-08 Routing checkpoint
    [Wheelchair.brd, Wheelchair.sch]
2012-03-08 Finished motor driver interface, still needs LCD backlight, joystick interface, photointerrupter inputs, etc
    [Wheelchair.brd, Wheelchair.sch]
2012-03-09 Added level shifter to motor driver interface
    [Wheelchair Receiver BOM.xlsx, Wheelchair.brd, Wheelchair.sch]
2012-03-09 Minor routing update
    [Wheelchair.brd, Wheelchair.sch]
2012-03-13 Finished LCD interface. Todo - limit switch, proportional joystick, photointerrupter, buttons
    [Wheelchair Receiver BOM.xlsx, Wheelchair.brd, Wheelchair.sch]
2012-03-15 Found a real level converter for the motor driver interface
    [Wheelchair Receiver BOM.xlsx, Wheelchair.brd, Wheelchair.sch]
2012-03-17 Added a real level translator to the LCD interface
    [Wheelchair Receiver BOM.xlsx, Wheelchair.brd, Wheelchair.sch]
2012-04-11 Started to add motor current sensor - needs work
    [Wheelchair Receiver BOM.xlsx, Wheelchair.brd, Wheelchair.sch]
2012-05-07 Unfinished current sensor moved to temporary PCB
    [Wheelchair.brd, Wheelchair.sch, currentsensor.brd, currentsensor.sch]
2012-05-08 Added inputs for proportional joystick, linear actuator feedback, photointerrupter, and LCD buttons
    [Wheelchair Receiver BOM.xlsx, Wheelchair.brd, Wheelchair.sch]
2012-05-09 Added bumper input, positioned mounting holes
    [Wheelchair.brd, Wheelchair.sch]
2012-05-09 fixed some DRC clearances
    [Wheelchair.brd, Wheelchair.sch]
2012-05-09 Fixed silkscreen clearance, prepping for manufacture
    [Wheelchair.brd]
2012-05-09 Untented vias, fixed some more silkscreen clearance issues, added gerbers
    [Wheelchair.brd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]
2012-05-14 Changed ACS710 to ACS716, updated BOM
    [Wheelchair Receiver BOM.xlsx, Wheelchair.brd, Wheelchair.sch]
2012-05-14 More work on the BOM
    [Wheelchair Receiver BOM.xlsx]
2012-05-15 Moved panel connectors and wiring to separate bill of materials
    [Connector BOM.xlsx, Wheelchair Receiver BOM.xlsx, Wheelchair.brd]
2012-05-15 Updated gerbers
    [Wheelchair.brd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]
2012-05-15 Wheelchair PCB Revision 2012A
    [Wheelchair.brd, Wheelchair.sch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]
2012-05-17 Wheelchair BOM Revision 2012A
    [Connector BOM.xlsx, Wheelchair Receiver BOM.xlsx]
2012-05-31 Reorganized files - moved atmel-provided drivers to separate folder
2012-05-31 Wheelchair code - got rid of warnings
2012-06-04 Wheelchair code - changed pins to match rev 2012A hardware, other cleanup
    [Wheelchair Receiver BOM.xlsx]
2012-06-05 Added skeleton .c and .h files for motor driver and LCD driver
2012-06-07 Remote code - got rid of some unused variable warnings. Wheelchair - cleaned up nordic wireless driver.
    [Remote BOM.xlsx]
2012-06-08 Wheelchair - moved test code to separate file
2012-06-08 Wheelchair - started developing the motor driver code. Hardware - updated BOMs.
    [Remote BOM.xlsx, Wheelchair Receiver BOM.xlsx]
2012-06-12 Wheelchair - attempt to clean up debug uart, small progress on motor driver
2012-06-13 Wheelchair code - reorganized header files other things
2012-06-14 Wheelchair code - added analog joystick driver, removed old bumper code, removed confusing and unmodular debounce interrupts, moved some program logic out of PWCT_io and into main
2012-06-15 Wheelchair code - added test that hooks proportional joystick up to motors
2012-06-20 Remote schematic - changed thumb joystick. Circuit design checkpoint.
    [Remote BOM.xlsx, Remote.brd, Remote.sch]
2012-06-22 Remote schematic and routing checkpoint
    [Remote BOM.xlsx, Remote.brd, Remote.sch]
2012-06-25 Remote schematic and board layout version 2012. Added gerber files.
    [Remote BOM.xlsx, Remote.brd, Remote.sch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]
2012-06-25 Remote circuit - added reverse battery protection diode
    [Remote BOM.xlsx, Remote.brd, Remote.sch]
2012-06-26 Remote BOM updated
    [Remote BOM.xlsx, Remote.brd, Remote.sch]
2012-06-27 Wheelchair - functional LCD driver written
    [Remote BOM.xlsx]
2012-06-27 Wheelchair - changed LCD to 4-bit interface
2012-07-03 Wheelchair - LCD driver is now interrupt-driven
    [Remote BOM.xlsx]
2012-07-10 Remote code - removed warnings and cleanup up wireless driver
2012-07-18 Wireless proportional joystick working
2012-07-29 Remote software compensates for sheared joystick axes
    [Connector BOM.xlsx, Remote BOM.xlsx]
2012-07-31 More wireless driver cleanup. Remote code now supports both student joystick and instructor remote.
2012-08-15 Wheelchair code - added a modular debouncing system
2012-08-22 Wheelchair - EEPROM storage working
2012-08-23 Wheelchair code - user-configurable center dead band
2012-09-20 Wheelchair code - added several additional menu options, decreased wireless timeout
    [Wheelchair Receiver BOM.xlsx]
2012-09-20 Wheelchair code - changed e-stop to normally closed switch, added reset count on LCD
    [PWCT_io.c, main.c, menu.c, menu.h]
2012-09-27 Committing prior to wireless code rework
    [nordic_driver.c, nordic_driver.h, nordic_hardware_specific.c, test.c, test.h]
2012-09-27 Wheelchair - rewrote wireless driver in an attempt to fix reset bug. Unfortunately the bug persists, but the new wireless driver is awesome.
    [PWCT_io.c, main.c, nordic_driver.c, nordic_driver.h, nordic_hardware_specific.c, nordic_hardware_specific.h, test.c]
2012-09-27 Wheelchair - finally fixed the reset bug. Woohoo\!
    [PWCT_io.c, lcd_driver.c, linear_actuator.c, motor_driver.c, nordic_driver.c, util.c]
2012-09-28 Wheelchair code - added a few more user-configurable parameters
2012-09-28 Wheelchair - hardcoded sensitivity filter implemented
2012-09-28 Wheelchair code - sensitivity aka tremor dampening now user-configurable
2012-09-28 Wheelchair code - outer deadband implemented and user-configurable
2012-10-03 Wheelchair - outer deadband ramps down instead of hard stop, sensitivity applies only while accelerating
2012-10-04 Wheelchair - don't drive while platform is down
2012-10-04 Remote - fixed auto acknowledge, plus other cleanup
    [main.c, nordic_driver.c, nordic_driver.h, nordic_hardware_specific.c]
2012-10-05 Wireless joystick now supports plug-in buttons
2012-10-05 Wheelchair - added limits to all menu options, changed accel/decel numbers
2012-10-06 Wheelchair - eeprom made more robust
2012-10-07 Wheelchair - display reset reason on LCD
    [main.c]
2012-10-07 Wheelchair - numbered profiles implemented
2012-10-07 Wheelchair - profiles have hardcoded names
2012-10-10 Wheelchair - instructor remote no longer controls speed or direction
    [PWCT_io.c, PWCT_io.h, joystick_algorithm.c, menu.c, nordic_driver.c, nordic_driver.h]
2012-10-11 Wheelchair - fixed wireless timeout regression bug, changed sensitivity numbers, improved dead zone algorithms
    [joystick_algorithm.c, menu.c, menu.h, nordic_driver.c]
2012-10-11 Wheelchair - e-stop input debounced
2012-10-11 Wheelchair - implemented longpress for debounced buttons
2012-10-12 Wheelchair - profile names user-configurable
2012-10-15 Wheelchair - wireless joystick overrides buddy buttons
2012-11-27 Remote - fixed overflow error and other cleanup
    [main.c, nordic_driver.c, nordic_driver.h, remote_hardware.c, remote_hardware.h]
2012-11-27 Wheelchair - instructor remote overrides student joystick, and must be on to operate
2012-11-28 Remote - debounced instructor remote e-stop. Wheelchair - display e-stop source (panel or remote) on LCD panel.
2012-11-29 Wheelchair - added special profile for remote override
2012-12-04 Decreased wireless bitrate to 250kbps, enabled 2 CRC bytes
2012-12-04 Remote - LED only turns on after a quarter second of TX retransmits
2012-12-04 Wheelchair - remote e-stop only if we receive two e-stop packets in a row
2013-03-14 Remote code - fixed student joystick LED logic
    [remote_hardware.c]
2014-04-01 Added fuse to BOM
    [Wheelchair Receiver BOM.xlsx]
